inspizzz/squid-16/docs/img/board-bottom.png

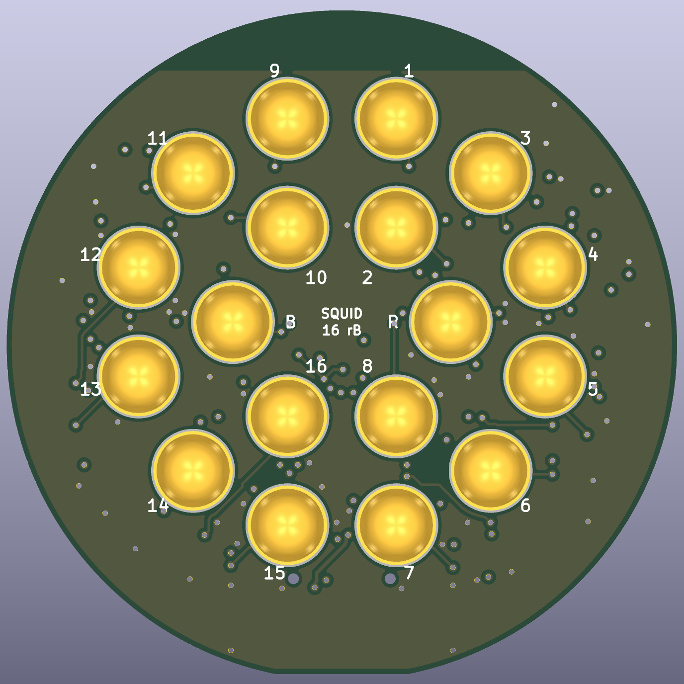
docs/img/board-bottom.png
