inspizzz/squid-16/docs/img/board-top.png

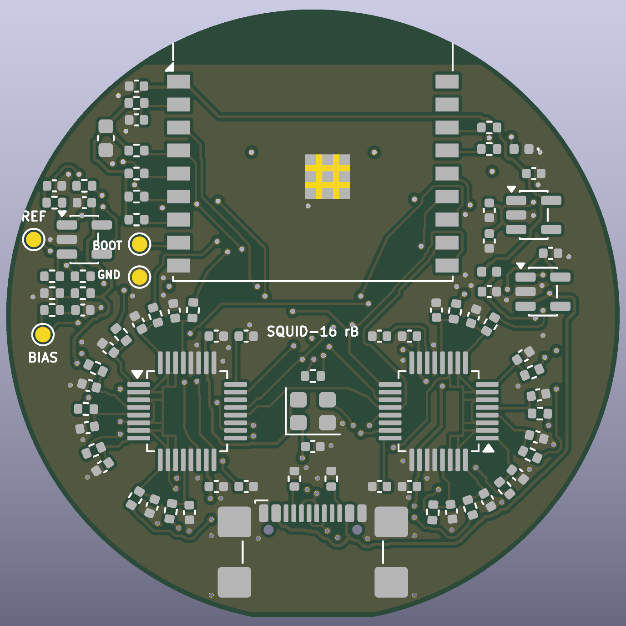
docs/img/board-top.png
