inspizzz/squid-16/docs/img/squid16-inner.png

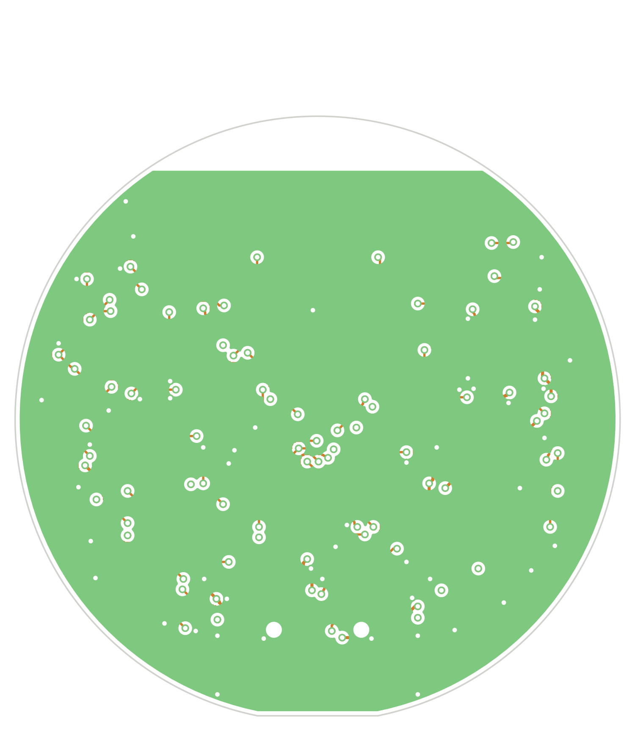
docs/img/squid16-inner.png
