inspizzz/squid-16/hardware/production/bom-jlcpcb.csv

Comment | Designator | Footprint | LCSC Part #
220p (Capacitor 220 pF C0G 0402) | C1,C2,C3,C4,C5,C6,C7,C8,C9,C10,C11,C12,C13,C14,C15,C16 | C_0402_1005Metric
1u (Capacitor 1 uF X5R 10 V 0402) | C17,C18,C20,C21,C24,C25,C30,C33,C36,C37 | C_0402_1005Metric
2.2u (Capacitor 2.2 uF X5R 6.3 V 0402) | C19 | C_0402_1005Metric
220n (Capacitor 220n 0402) | C22,C26 | C_0402_1005Metric
100n (Capacitor 100n 0402) | C23,C27,C28,C29,C35 | C_0402_1005Metric
10n (Capacitor 10 nF C0G 0402) | C31 | C_0402_1005Metric
10u (Capacitor 10 uF X5R 6.3 V 0603) | C34 | C_0603_1608Metric
generic 0402 green LED | D1 | LED_0402_1005Metric
BLM15AG601SN1D | FB1 | L_0402_1005Metric
USB4110-GF-A | J1 | USB_C_Receptacle_GCT_USB4110
4k7 (Resistor 4k7 1% 0402) | R1,R2,R3,R4,R5,R6,R7,R8,R9,R10,R11,R12,R13,R14,R15,R16 | R_0402_1005Metric
10k (Resistor 10k 1% 0402) | R17,R21,R29,R36,R37,R38 | R_0402_1005Metric
100R (Resistor 100R 0402. Fitted: reference node driven by the buffer) | R18 | R_0402_1005Metric
20k (Resistor 20k 1% 0402. Remove to hold the bias electrode at ground instead of 1.1 V) | R20 | R_0402_1005Metric
2k2 (Resistor 2k2 1% 0402) | R22 | R_0402_1005Metric
33R (Resistor 33R 1% 0402) | R23 | R_0402_1005Metric
10M (Resistor 10M 0402: holds the buffer input at the bias voltage when the reference pin is not touching) | R28 | R_0402_1005Metric
5k1 (Resistor 5k1 1% 0402, USB-C sink ID) | R30,R31 | R_0402_1005Metric
10k (Resistor 10k 0402, boot strap pull-up) | R33,R34 | R_0402_1005Metric
1k (Resistor 1k 1% 0402) | R35 | R_0402_1005Metric
ADS131M08IPBSR | U1,U2 | TQFP-32_5x5mm_P0.5mm
LP5907MFX-3.3/NOPB | U3 | SOT-23-5
OPA376AIDBVR | U4 | SOT-23-5
ESP32-C3-WROOM-02-N4 | U5 | ESP32-C3-WROOM-02_NoVias
AP2112K-3.3TRG1 | U6 | SOT-23-5
SiT1602BC-11-33E-8.192000 | Y1 | Oscillator_SMD_SiT_PQFN-4Pin_2.5x2.0mm
