inspizzz/squid-16/hardware/production/squid16-schematic.pdf

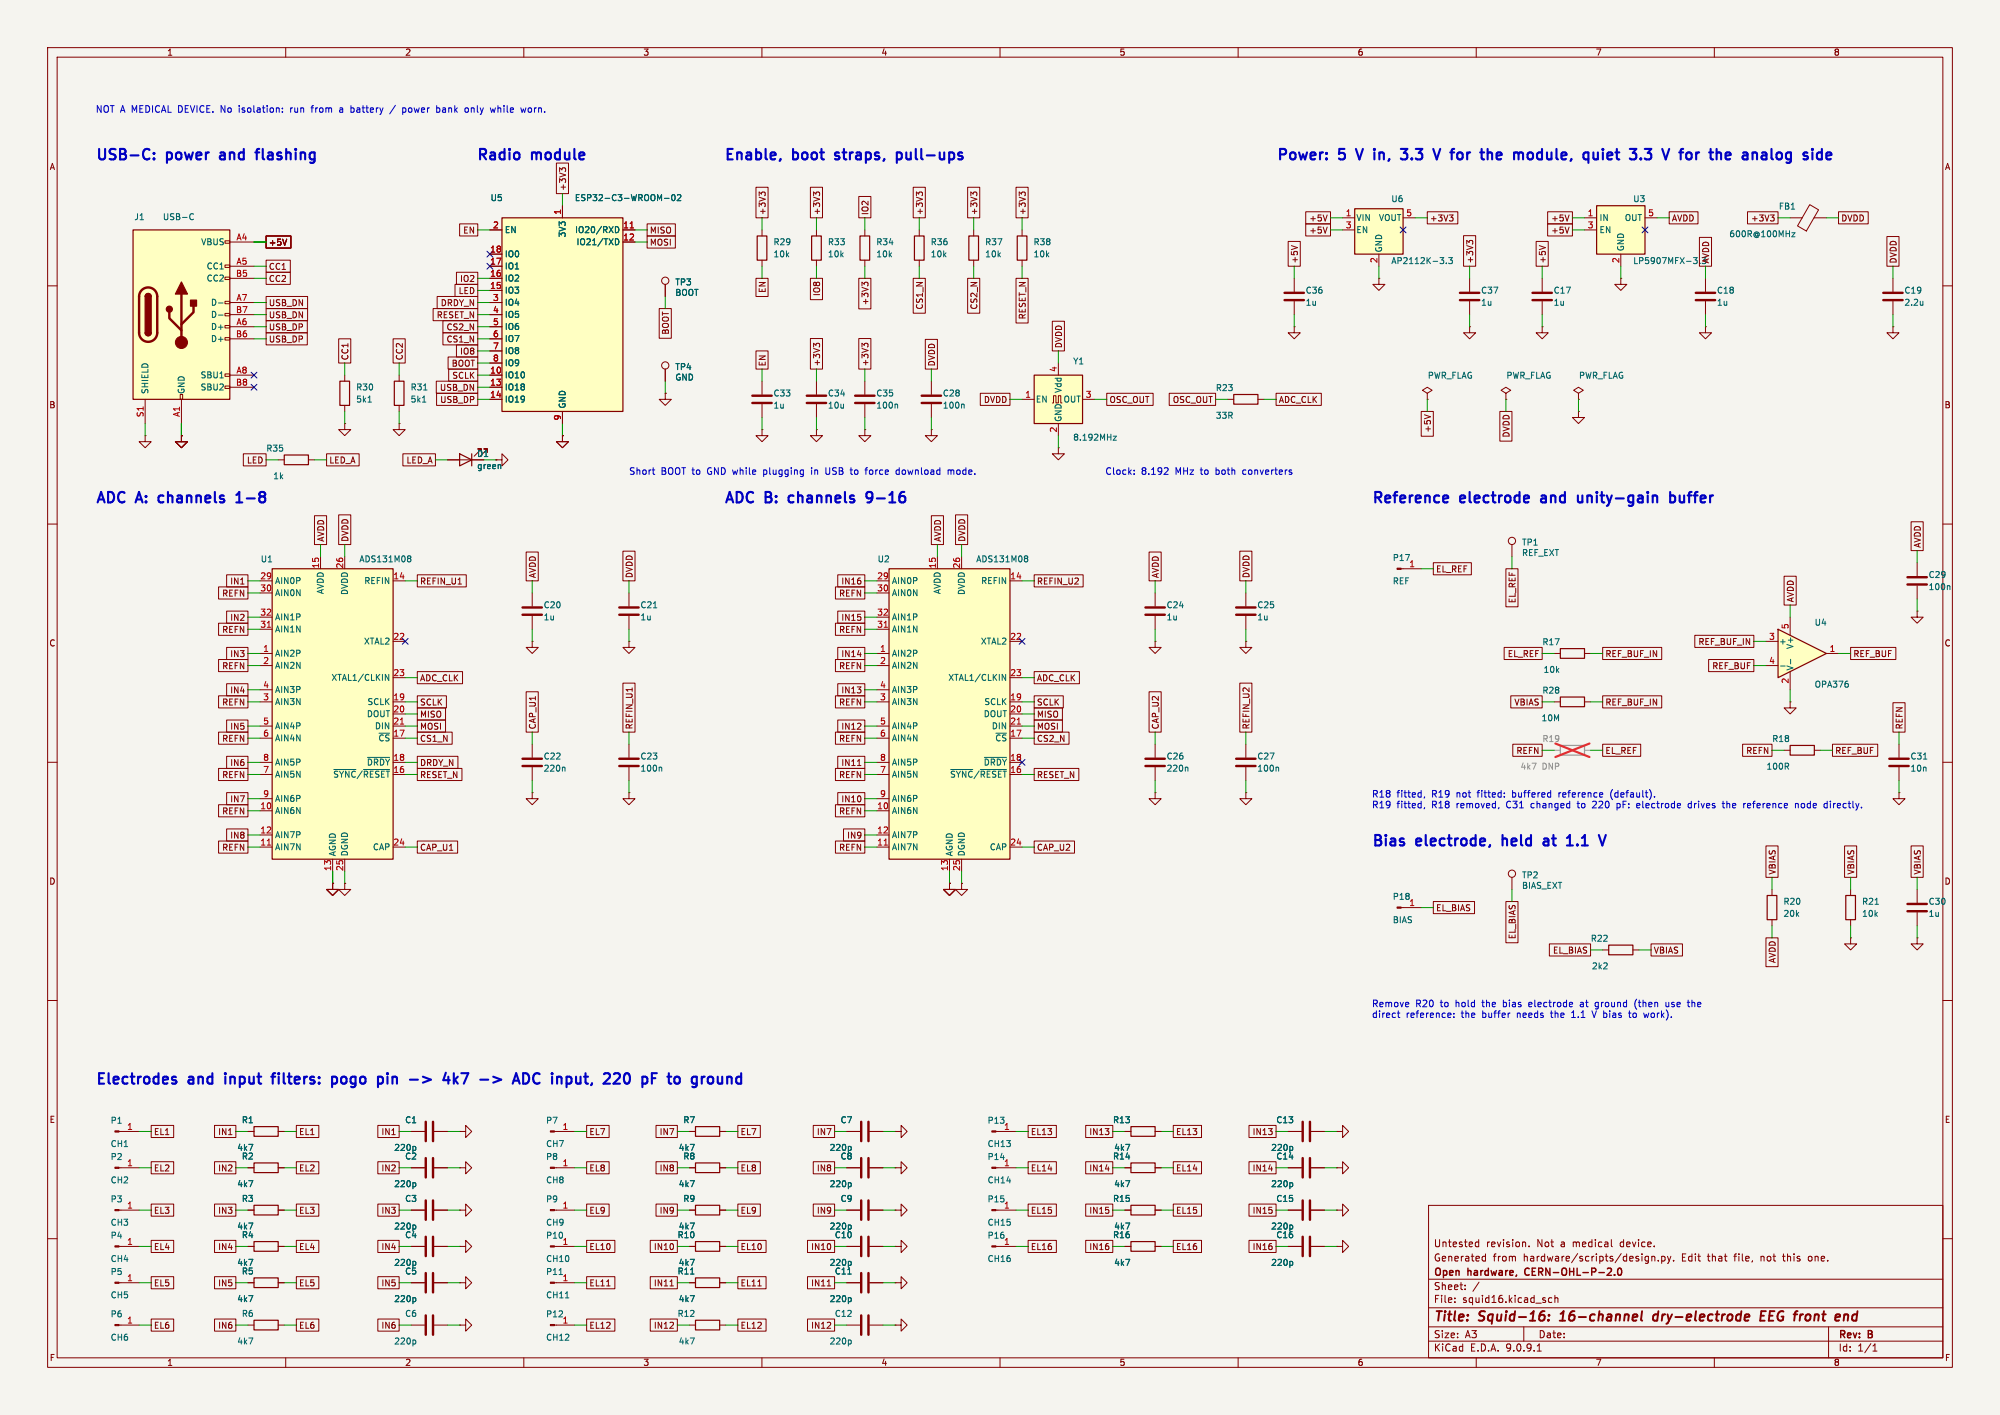
[picture p11: page 1]

Clock: 8.192 MHz to both converters Enable, boot straps, pull-ups
