inspizzz/squid-16/hardware/production/squid16-assembly-top.pdf

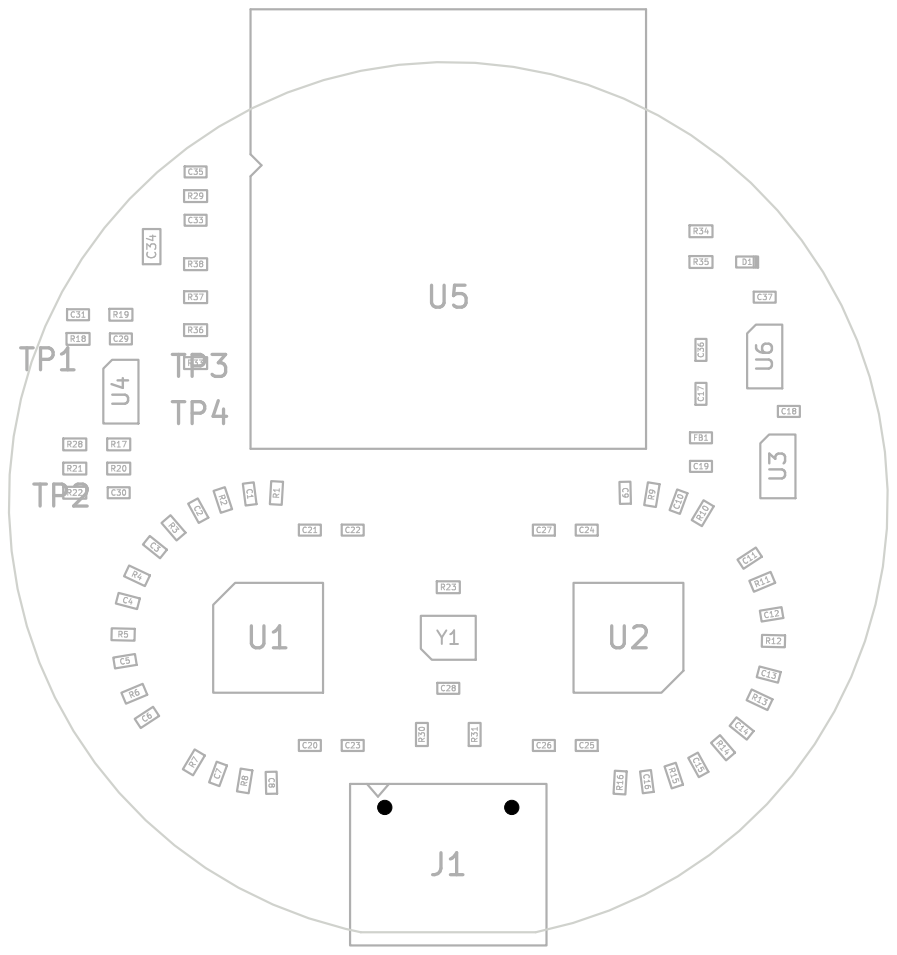
[picture p12: page 1]
