inspizzz/squid-16/hardware/squid16.kicad_pcb

## KiCad design hardware/squid16.kicad_pcb (2026-11-10)

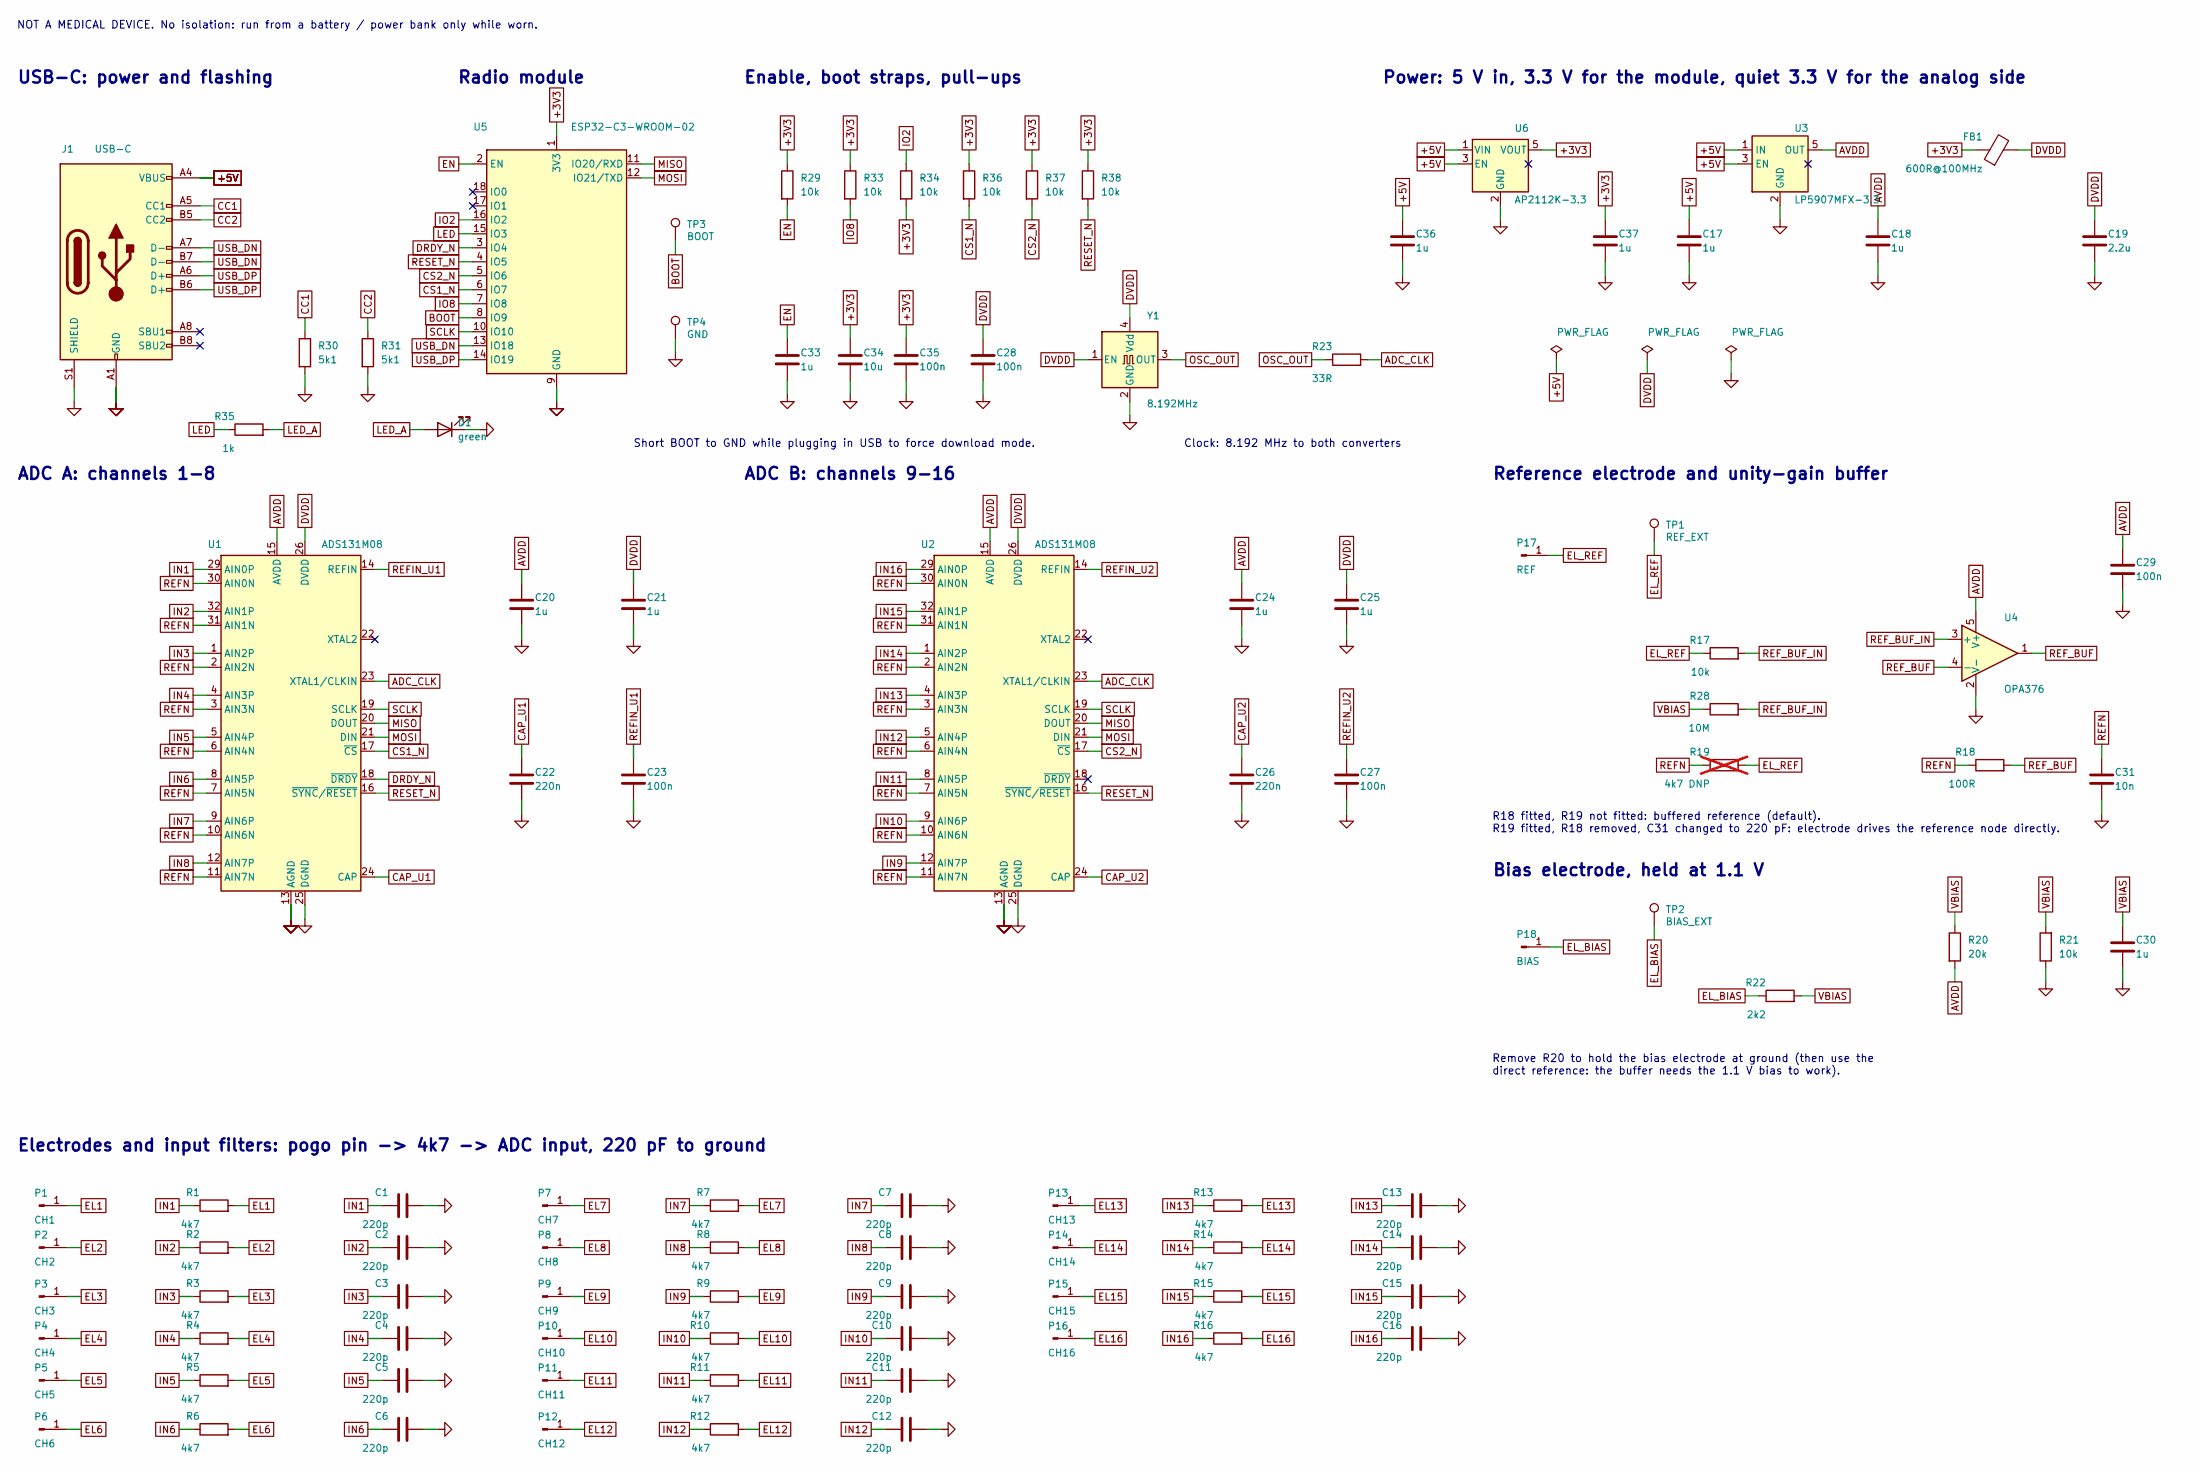
[picture p13: schematic squid16.kicad_sch, Squid-16: 16-channel dry-electrode EEG front end]

Parts:
C1, C2, C3, C4, C5, C6, C7, C8, C9, C10, C11, C12, C13, C14, C15, C16: 220p; C_0402_1005Metric
C17, C18, C20, C21, C24, C25, C30, C33, C36, C37: 1u; C_0402_1005Metric
C19: 2.2u; C_0402_1005Metric
C22, C26: 220n; C_0402_1005Metric
C23, C27, C28, C29, C35: 100n; C_0402_1005Metric
C31: 10n; C_0402_1005Metric
C34: 10u; C_0603_1608Metric
D1: green; LED_0402_1005Metric; MPN generic 0402 green LED
FB1: 600R@100MHz; L_0402_1005Metric; MPN BLM15AG601SN1D
J1: USB-C; USB_C_Receptacle_GCT_USB4110; MPN USB4110-GF-A
P1: CH1; PogoPin_MillMax_0845_SMD; MPN 0845-0-15-20-52-14-11-0
P2: CH2; PogoPin_MillMax_0845_SMD; MPN 0845-0-15-20-52-14-11-0
P3: CH3; PogoPin_MillMax_0845_SMD; MPN 0845-0-15-20-52-14-11-0
P4: CH4; PogoPin_MillMax_0845_SMD; MPN 0845-0-15-20-52-14-11-0
P5: CH5; PogoPin_MillMax_0845_SMD; MPN 0845-0-15-20-52-14-11-0
P6: CH6; PogoPin_MillMax_0845_SMD; MPN 0845-0-15-20-52-14-11-0
P7: CH7; PogoPin_MillMax_0845_SMD; MPN 0845-0-15-20-52-14-11-0
P8: CH8; PogoPin_MillMax_0845_SMD; MPN 0845-0-15-20-52-14-11-0
P9: CH9; PogoPin_MillMax_0845_SMD; MPN 0845-0-15-20-52-14-11-0
P10: CH10; PogoPin_MillMax_0845_SMD; MPN 0845-0-15-20-52-14-11-0
P11: CH11; PogoPin_MillMax_0845_SMD; MPN 0845-0-15-20-52-14-11-0
P12: CH12; PogoPin_MillMax_0845_SMD; MPN 0845-0-15-20-52-14-11-0
P13: CH13; PogoPin_MillMax_0845_SMD; MPN 0845-0-15-20-52-14-11-0
P14: CH14; PogoPin_MillMax_0845_SMD; MPN 0845-0-15-20-52-14-11-0
P15: CH15; PogoPin_MillMax_0845_SMD; MPN 0845-0-15-20-52-14-11-0
P16: CH16; PogoPin_MillMax_0845_SMD; MPN 0845-0-15-20-52-14-11-0
P17: REF; PogoPin_MillMax_0845_SMD; MPN 0845-0-15-20-52-14-11-0
P18: BIAS; PogoPin_MillMax_0845_SMD; MPN 0845-0-15-20-52-14-11-0
R1, R2, R3, R4, R5, R6, R7, R8, R9, R10, R11, R12, R13, R14, R15, R16: 4k7; R_0402_1005Metric
R17, R21, R29, R33, R34, R36, R37, R38: 10k; R_0402_1005Metric
R18: 100R; R_0402_1005Metric
R19: 4k7 DNP; R_0402_1005Metric; not fitted
R20: 20k; R_0402_1005Metric
R22: 2k2; R_0402_1005Metric
R23: 33R; R_0402_1005Metric
R28: 10M; R_0402_1005Metric
R30, R31: 5k1; R_0402_1005Metric
R35: 1k; R_0402_1005Metric
TP1: REF_EXT; TestPoint_Pad_D1.0mm
TP2: BIAS_EXT; TestPoint_Pad_D1.0mm
TP3: BOOT; TestPoint_Pad_D1.0mm
TP4: GND; TestPoint_Pad_D1.0mm
U1, U2: ADS131M08; TQFP-32_5x5mm_P0.5mm; MPN ADS131M08IPBSR
U3: LP5907MFX-3.3; SOT-23-5; MPN LP5907MFX-3.3/NOPB
U4: OPA376; SOT-23-5; MPN OPA376AIDBVR
U5: ESP32-C3-WROOM-02; ESP32-C3-WROOM-02_NoVias; MPN ESP32-C3-WROOM-02-N4
U6: AP2112K-3.3; SOT-23-5; MPN AP2112K-3.3TRG1
Y1: 8.192MHz; Oscillator_SMD_SiT_PQFN-4Pin_2.5x2.0mm; MPN SiT1602BC-11-33E-8.192000

Connections:
+3V3: C34.2, C35.2, C37.1, FB1.1, R29.1, R33.1, R34.2, R36.1, R37.1, R38.1, U5.1 (3V3), U6.5 (VOUT)
+5V: C17.2, C36.2, J1.A4 (VBUS), J1.A9 (VBUS), J1.B4 (VBUS), J1.B9 (VBUS), U3.1 (IN), U3.3 (EN), U6.1 (VIN), U6.3 (EN)
ADC_CLK: R23.2, U1.23 (XTAL1/CLKIN), U2.23 (XTAL1/CLKIN)
AVDD: C18.1, C20.1, C24.1, C29.2, R20.2, U1.15 (AVDD), U2.15 (AVDD), U3.5 (OUT), U4.5 (V+)
BOOT: TP3.1, U5.8 (IO9)
CAP_U1: C22.1, U1.24 (CAP)
CAP_U2: C26.1, U2.24 (CAP)
CC1: J1.A5 (CC1), R30.1
CC2: J1.B5 (CC2), R31.1
CS1_N: R36.2, U1.17 (~CS), U5.6 (IO7)
CS2_N: R37.2, U2.17 (~CS), U5.5 (IO6)
DRDY_N: U1.18 (~DRDY), U5.3 (IO4)
DVDD: C19.1, C21.1, C25.1, C28.1, FB1.2, U1.26 (DVDD), U2.26 (DVDD), Y1.1 (EN), Y1.4 (Vdd)
EL1: P1.1, R1.2
EL2: P2.1, R2.2
EL3: P3.1, R3.2
EL4: P4.1, R4.2
EL5: P5.1, R5.2
EL6: P6.1, R6.2
EL7: P7.1, R7.2
EL8: P8.1, R8.2
EL9: P9.1, R9.2
EL10: P10.1, R10.2
EL11: P11.1, R11.2
EL12: P12.1, R12.2
EL13: P13.1, R13.2
EL14: P14.1, R14.2
EL15: P15.1, R15.2
EL16: P16.1, R16.2
EL_BIAS: P18.1, R22.1, TP2.1
EL_REF: P17.1, R17.1, R19.2, TP1.1
EN: C33.2, R29.2, U5.2 (EN)
GND: C1.2, C2.2, C3.2, C4.2, C5.2, C6.2, C7.2, C8.2, C9.2, C10.2, C11.2, C12.2, C13.2, C14.2, C15.2, C16.2, C17.1, C18.2, C19.2, C20.2, C21.2, C22.2, C23.2, C24.2, C25.2, C26.2, C27.2, C28.2, C29.1, C30.2, C31.2, C33.1, C34.1, C35.1, C36.1, C37.2, D1.1 (K), J1.A1 (GND), J1.A12 (GND), J1.B1 (GND), J1.B12 (GND), J1.S1 (SHIELD), R21.1, R30.2, R31.2, TP4.1, U1.13 (AGND), U1.25 (DGND), U1.27 (AGND), U1.28 (AGND), U2.13 (AGND), U2.25 (DGND), U2.27 (AGND), U2.28 (AGND), U3.2 (GND), U4.2 (V-), U5.9 (GND), U5.19 (GND), U6.2 (GND), Y1.2 (GND)
IN1: C1.1, R1.1, U1.29 (AIN0P)
IN2: C2.1, R2.1, U1.32 (AIN1P)
IN3: C3.1, R3.1, U1.1 (AIN2P)
IN4: C4.1, R4.1, U1.4 (AIN3P)
IN5: C5.1, R5.1, U1.5 (AIN4P)
IN6: C6.1, R6.1, U1.8 (AIN5P)
IN7: C7.1, R7.1, U1.9 (AIN6P)
IN8: C8.1, R8.1, U1.12 (AIN7P)
IN9: C9.1, R9.1, U2.12 (AIN7P)
IN10: C10.1, R10.1, U2.9 (AIN6P)
IN11: C11.1, R11.1, U2.8 (AIN5P)
IN12: C12.1, R12.1, U2.5 (AIN4P)
IN13: C13.1, R13.1, U2.4 (AIN3P)
IN14: C14.1, R14.1, U2.1 (AIN2P)
IN15: C15.1, R15.1, U2.32 (AIN1P)
IN16: C16.1, R16.1, U2.29 (AIN0P)
IO2: R34.1, U5.16 (IO2)
IO8: R33.2, U5.7 (IO8)
LED: R35.1, U5.15 (IO3)
LED_A: D1.2 (A), R35.2
MISO: U1.20 (DOUT), U2.20 (DOUT), U5.11 (IO20/RXD)
MOSI: U1.21 (DIN), U2.21 (DIN), U5.12 (IO21/TXD)
OSC_OUT: R23.1, Y1.3 (OUT)
REFIN_U1: C23.1, U1.14 (REFIN)
REFIN_U2: C27.1, U2.14 (REFIN)
REFN: C31.1, R18.1, R19.1, U1.2 (AIN2N), U1.3 (AIN3N), U1.6 (AIN4N), U1.7 (AIN5N), U1.10 (AIN6N), U1.11 (AIN7N), U1.30 (AIN0N), U1.31 (AIN1N), U2.2 (AIN2N), U2.3 (AIN3N), U2.6 (AIN4N), U2.7 (AIN5N), U2.10 (AIN6N), U2.11 (AIN7N), U2.30 (AIN0N), U2.31 (AIN1N)
REF_BUF: R18.2, U4.1, U4.4 (-)
REF_BUF_IN: R17.2, R28.2, U4.3 (+)
RESET_N: R38.2, U1.16 (~SYNC/~RESET), U2.16 (~SYNC/~RESET), U5.4 (IO5)
SCLK: U1.19 (SCLK), U2.19 (SCLK), U5.10 (IO10)
USB_DN: J1.A7 (D-), J1.B7 (D-), U5.13 (IO18)
USB_DP: J1.A6 (D+), J1.B6 (D+), U5.14 (IO19)
VBIAS: C30.1, R20.1, R21.2, R22.2, R28.1

Notes on the sheet:
USB-C: power and flashing
Radio module
Enable, boot straps, pull-ups
Power: 5 V in, 3.3 V for the module, quiet 3.3 V for the analog side
ADC A: channels 1-8
ADC B: channels 9-16
Reference electrode and unity-gain buffer
Bias electrode, held at 1.1 V
Electrodes and input filters: pogo pin -> 4k7 -> ADC input, 220 pF to ground
Clock: 8.192 MHz to both converters
Short BOOT to GND while plugging in USB to force download mode.
R18 fitted, R19 not fitted: buffered reference (default). R19 fitted, R18 removed, C31 changed to 220 pF: electrode drives the reference node directly.
Remove R20 to hold the bias electrode at ground (then use the direct reference: the buffer needs the 1.1 V bias to work).
NOT A MEDICAL DEVICE. No isolation: run from a battery / power bank only while worn.

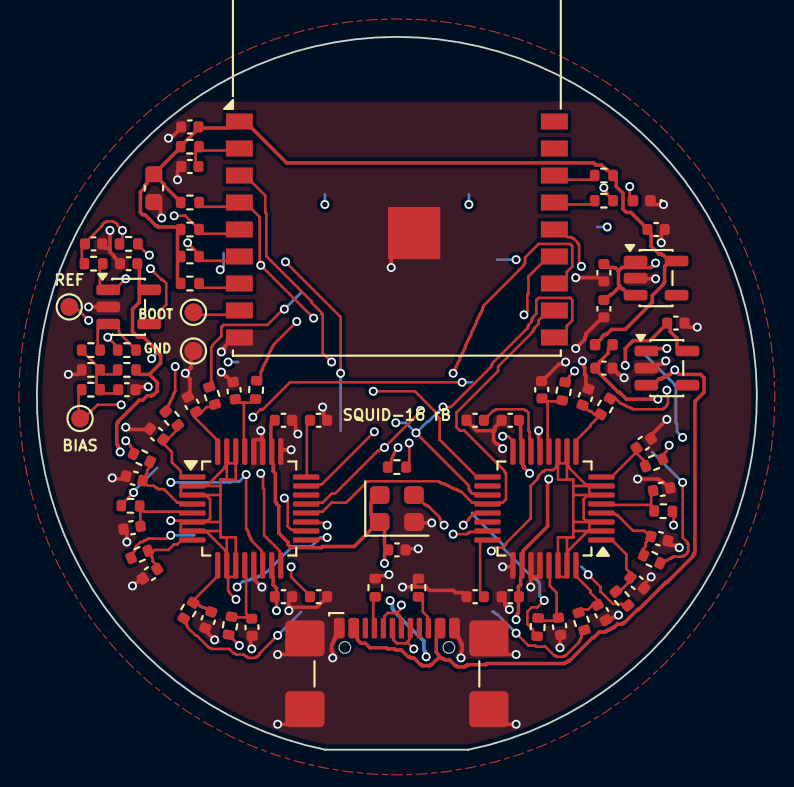
[picture p14: board squid16.kicad_pcb from above]

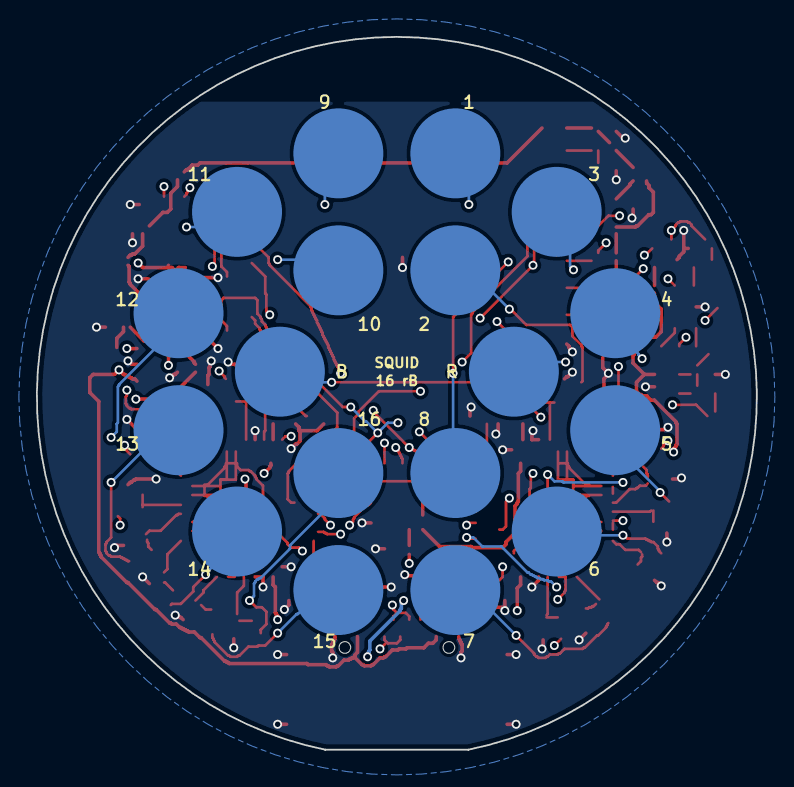
[picture p15: board squid16.kicad_pcb from below]

Board: 4 copper layers, 40.0 x 39.6 mm, 101 parts (18 on the bottom side), 66 nets.
