inspizzz/squid-16/(commit log)

2026-11-10 Limpet-16 revision A: 16-channel dry-electrode EEG front end
    Hardware (KiCad 9, generated from hardware/scripts/design.py), firmware for
    the XIAO ESP32-S3, a Bluetooth recorder and build documentation.
    Unbuilt and untested; see README for what has been verified.
    [bom-jlcpcb.csv, bom.csv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]
2026-11-10 Revision B: ESP32-C3-WROOM-02 module and USB-C on a 40 mm board
    Replaces the plug-in XIAO and its sockets. Adds a 3.3 V regulator for the
    module, boot straps, chip-select pull-ups and a hold resistor on the
    reference buffer input. Router gains rotated pads, keep-outs, multi-phase
    rip-up. Unbuilt and untested.
    [bom-jlcpcb.csv, bom.csv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]
2026-11-10 Router: document that rebuilds are not repeatable; build.sh restores the previous board on failure
2026-11-10 Correct the nominal sample rate to 250 SPS (datasheet tables), flag it as unmeasured
    [ads131m08.h, main.cpp, test_host.cpp]
2026-11-10 Add board simulation framework (sim/) and its results
2026-11-10 Simulation: correct high-gain input model, add input-current and impedance sweeps; update findings
    [experiments.py, models.py, run_all.py]
2026-11-10 Add PCBWay order package and its generator
2026-11-10 README for release: render, how to get one, costs; pin 3D model; footprint licence notice
    [limpet16.kicad_pcb]
2026-11-10 Rename project to Squid-16
    Files, silkscreen, footprint library, firmware Bluetooth name (Squid-16-XXXX),
    docs and order package. Routed copper unchanged; ERC/DRC/parity re-run clean.
    [limpet16-B_Cu.gbl, limpet16-B_Mask.gbs, limpet16-B_Paste.gbp, limpet16-B_Silkscreen.gbo, limpet16-Edge_Cuts.gm1, limpet16-F_Cu.gtl, limpet16-F_Mask.gts, limpet16-F_Paste.gtp]
