inspizzz/squid-16/(notices)

Notices in the files:
hardware/squid16.kicad_sch:
Open hardware, CERN-OHL-P-2.0
